MissouriMRDT/12V_Hardware/Hardware/2022_Rev2/2022_Rev2.kicad_pcb

## KiCad design Hardware/2022_Rev2/2022_Rev2.kicad_pcb (2022-08-24)

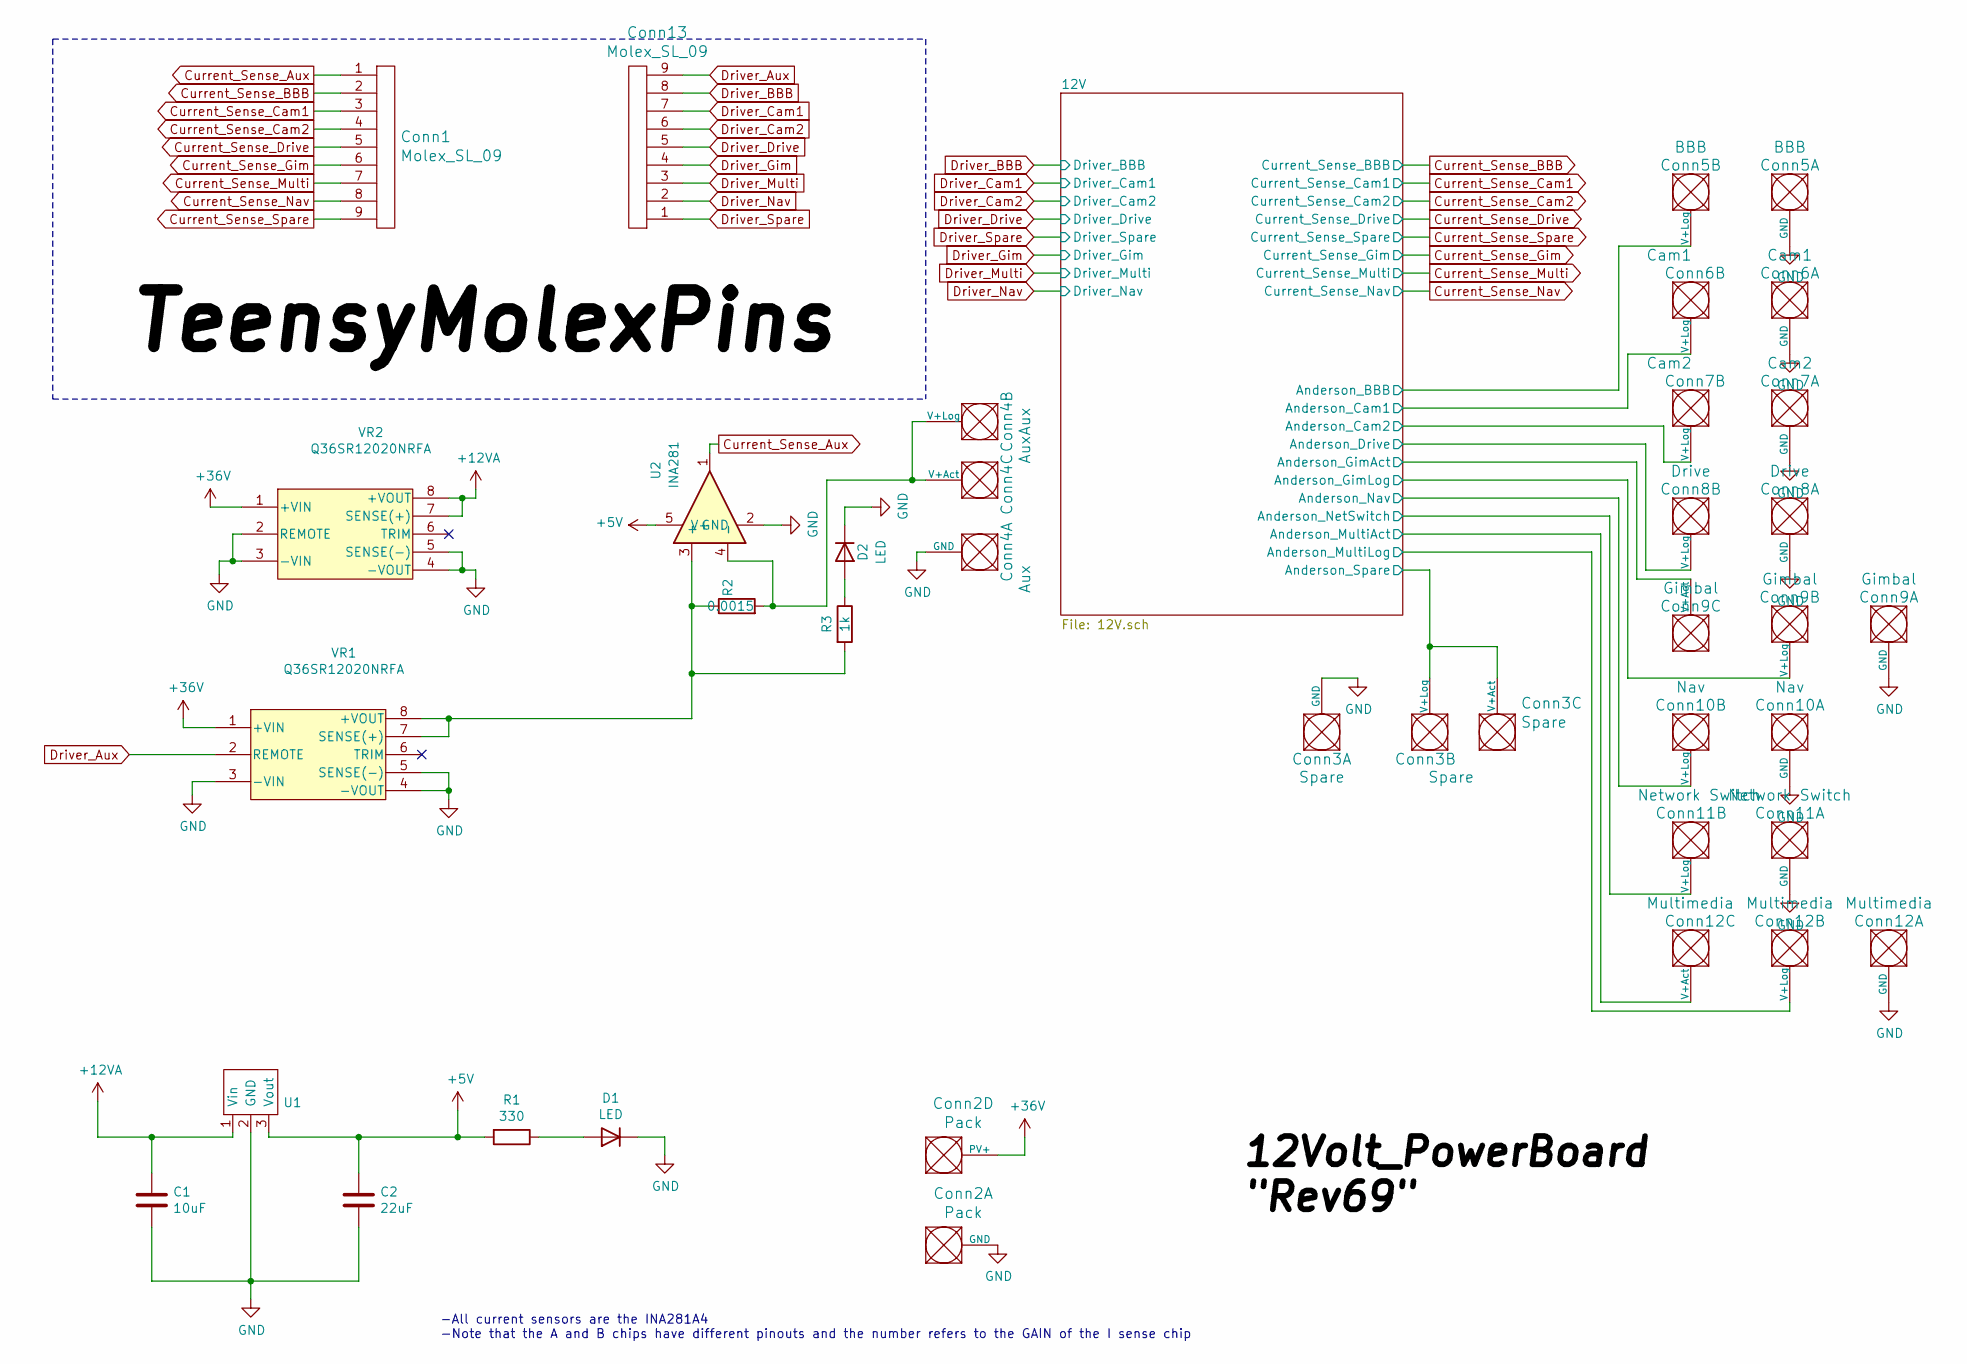
[picture p1: schematic 2022_Rev2.sch]

Parts:
C1: 10uF; C_0603_1608Metric_Pad1.05x0.95mm_HandSolder
C2: 22uF; C_0603_1608Metric_Pad1.05x0.95mm_HandSolder
Conn1, Conn13: Molex_SL_09; MOLEX_SL_09_Horizontal
Conn2: Pack; Square_Anderson_2_H_Stacked
Conn3: Spare; Square_Anderson_3_H_Side_By_Side
Conn4: Aux; Square_Anderson_3_H_Side_By_Side
Conn5: BBB; Square_Anderson_2_H_Stacked_PV
Conn6: Cam1; Square_Anderson_2_H_Stacked_PV
Conn7: Cam2; Square_Anderson_2_H_Stacked_PV
Conn8: Drive; Square_Anderson_2_H_Stacked_PV
Conn9: Gimbal; Square_Anderson_3_H_Side_By_Side
Conn10: Nav; Square_Anderson_2_H_Stacked_PV
Conn11: Network Switch; Square_Anderson_2_H_Stacked_PV
Conn12: Multimedia; Square_Anderson_3_H_Side_By_Side
D1, D2: LED; D_0603_1608Metric_Pad1.05x0.95mm_HandSolder
R1: 330; R_0603_1608Metric_Pad1.05x0.95mm_HandSolder
R2: 0.0015; R_2512_6332Metric_Pad1.52x3.35mm_HandSolder
R3: 1k; R_0603_1608Metric_Pad1.05x0.95mm_HandSolder
U1: TSR1-2433; TSR_1-2433
U2: INA281; SOT-23-5
VR1, VR2: Q36SR12020NRFA

Connections:
+5V: C2.1, R1.2, U1.3 (Vout), U2.5 (V+); also elsewhere on the board
+12VA: C1.1, Conn11.2 (V+Log), U1.1 (Vin), VR2.7 (SENSE(+)), VR2.8 (+VOUT); also elsewhere on the board
+36V: Conn2.4 (PV+), VR1.1 (+VIN), VR2.1 (+VIN)
/12V/Anderson_BBB: Conn5.2 (V+Log); also elsewhere on the board
/12V/Anderson_Cam1: Conn6.2 (V+Log); also elsewhere on the board
/12V/Anderson_Cam2: Conn7.2 (V+Log); also elsewhere on the board
/12V/Anderson_Drive: Conn8.2 (V+Log); also elsewhere on the board
/12V/Anderson_GimAct: Conn9.2 (V+Log), Conn9.3 (V+Act); also elsewhere on the board
/12V/Anderson_MultiAct: Conn12.2 (V+Log), Conn12.3 (V+Act); also elsewhere on the board
/12V/Anderson_Nav: Conn10.2 (V+Log); also elsewhere on the board
/12V/Anderson_Spare: Conn3.2 (V+Log), Conn3.3 (V+Act); also elsewhere on the board
Current_Sense_Aux: Conn1.1, U2.1
Current_Sense_BBB: Conn1.2; also elsewhere on the board
Current_Sense_Cam1: Conn1.3; also elsewhere on the board
Current_Sense_Cam2: Conn1.4; also elsewhere on the board
Current_Sense_Drive: Conn1.5; also elsewhere on the board
Current_Sense_Gim: Conn1.6; also elsewhere on the board
Current_Sense_Multi: Conn1.7; also elsewhere on the board
Current_Sense_Nav: Conn1.8; also elsewhere on the board
Current_Sense_Spare: Conn1.9; also elsewhere on the board
Driver_Aux: Conn13.9, VR1.2 (REMOTE)
Driver_BBB: Conn13.8; also elsewhere on the board
Driver_Cam1: Conn13.7; also elsewhere on the board
Driver_Cam2: Conn13.6; also elsewhere on the board
Driver_Drive: Conn13.5; also elsewhere on the board
Driver_Gim: Conn13.4; also elsewhere on the board
Driver_Multi: Conn13.3; also elsewhere on the board
Driver_Nav: Conn13.2; also elsewhere on the board
Driver_Spare: Conn13.1; also elsewhere on the board
GND: C1.2, C2.2, Conn2.1 (GND), Conn3.1 (GND), Conn4.1 (GND), Conn5.1 (GND), Conn6.1 (GND), Conn7.1 (GND), Conn8.1 (GND), Conn9.1 (GND), Conn10.1 (GND), Conn11.1 (GND), Conn12.1 (GND), D1.1 (K), D2.1 (K), U1.2 (GND), U2.2 (GND), VR1.3 (-VIN), VR1.4 (-VOUT), VR1.5 (SENSE(-)), VR2.2 (REMOTE), VR2.3 (-VIN), VR2.4 (-VOUT), VR2.5 (SENSE(-)); also elsewhere on the board
unnamed: Conn4.2 (V+Log), Conn4.3 (V+Act), R2.2, U2.4 (-)
unnamed: D1.2 (A), R1.1
unnamed: D2.2 (A), R3.1
unnamed: R2.1, R3.2, U2.3 (+), VR1.7 (SENSE(+)), VR1.8 (+VOUT)

Notes on the sheet:
-All current sensors are the INA281A4 -Note that the A and B chips have different pinouts and the number refers to the GAIN of the I sense chip

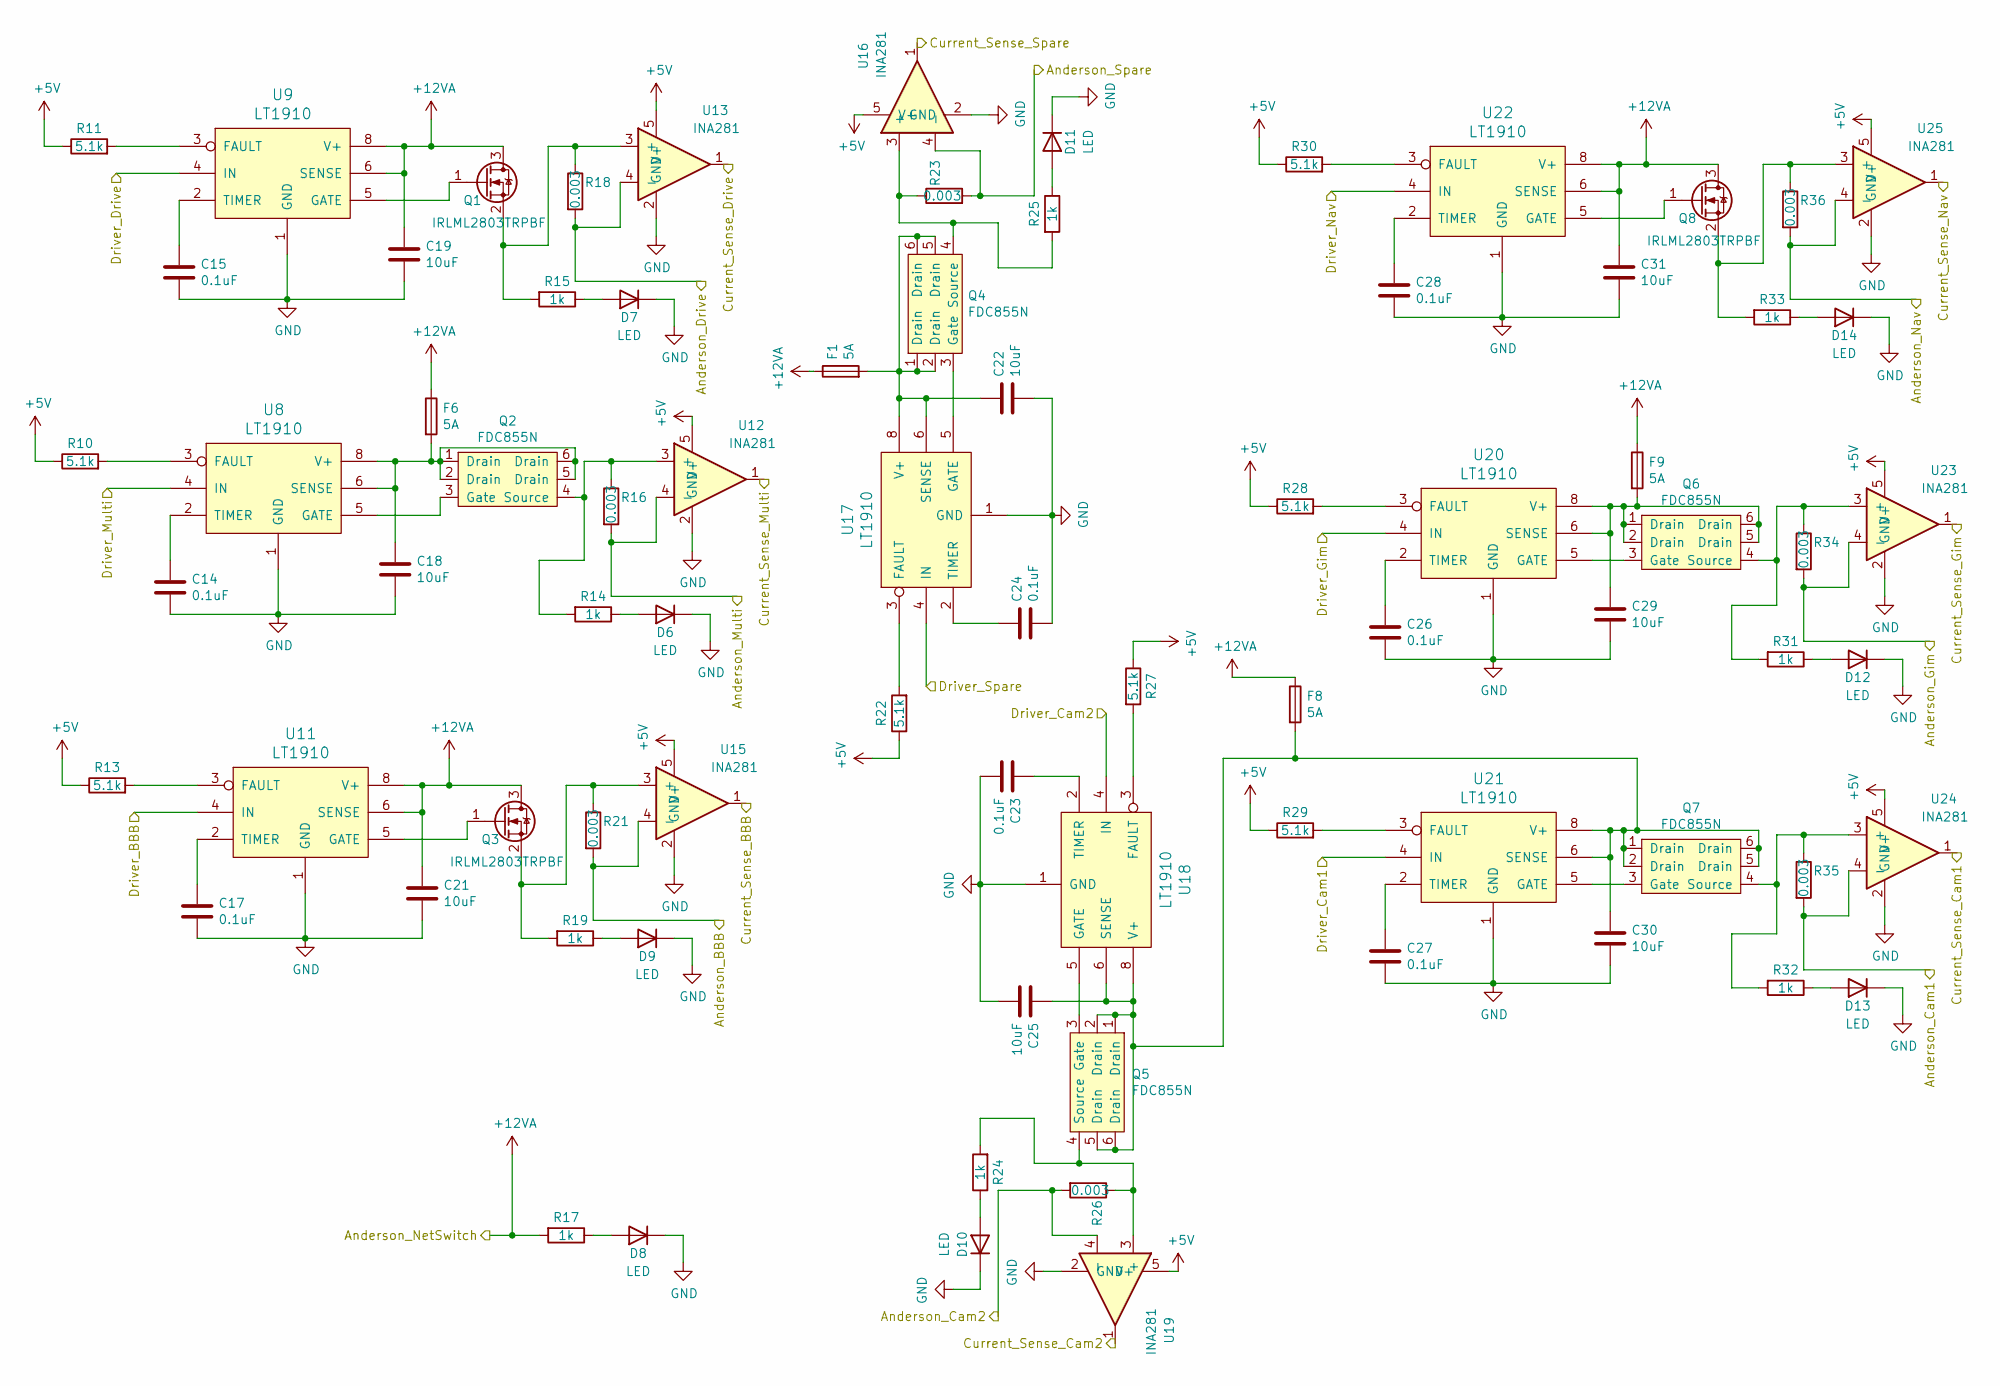
[picture p2: schematic Low Current Out.sch]

Parts:
C14, C15, C17, C23, C24, C26, C27, C28: 0.1uF; C_0603_1608Metric_Pad1.05x0.95mm_HandSolder
C18, C19, C21, C22, C25, C29, C30, C31: 10uF; C_0603_1608Metric_Pad1.05x0.95mm_HandSolder
D6, D7, D8, D9, D10, D11, D12, D13, D14: LED; D_0603_1608Metric_Pad1.05x0.95mm_HandSolder
F1, F6, F8, F9: 5A; ATC_Fuse_Block
Q1, Q3, Q8: IRLML2803TRPBF; SOT-23
Q2, Q4, Q5, Q6, Q7: FDC855N; SuperSOT-6
R10, R11, R13, R22, R27, R28, R29, R30: 5.1k; R_0603_1608Metric_Pad1.05x0.95mm_HandSolder
R14, R15, R17, R19, R24, R25, R31, R32, R33: 1k; R_0603_1608Metric_Pad1.05x0.95mm_HandSolder
R16, R18, R21, R23, R26, R34, R35, R36: 0.003; R_2010_5025Metric_Pad1.52x2.65mm_HandSolder
U8, U9, U11, U17, U18, U20, U21, U22: LT1910; SOIC-8_3.9x4.9mm_P1.27mm
U12, U13, U15, U16, U19, U23, U24, U25: INA281; SOT-23-5

Connections:
+5V: R10.1, R11.1, R13.1, R22.1, R27.1, R28.1, R29.1, R30.1, U12.5 (V+), U13.5 (V+), U15.5 (V+), U16.5 (V+), U19.5 (V+), U23.5 (V+), U24.5 (V+), U25.5 (V+); also elsewhere on the board
+12VA: C19.1, C21.1, C31.1, F1.1, F6.1, F8.1, F9.1, Q1.3 (D), Q3.3 (D), Q8.3 (D), R17.2, U9.6 (SENSE), U9.8 (V+), U11.6 (SENSE), U11.8 (V+), U22.6 (SENSE), U22.8 (V+); also elsewhere on the board
/12V/Anderson_BBB: R21.2, U15.4 (-); also elsewhere on the board
/12V/Anderson_Cam1: R35.2, U24.4 (-); also elsewhere on the board
/12V/Anderson_Cam2: R26.2, U19.4 (-); also elsewhere on the board
/12V/Anderson_Drive: R18.2, U13.4 (-); also elsewhere on the board
/12V/Anderson_GimAct: R34.2, U23.4 (-); also elsewhere on the board
/12V/Anderson_MultiAct: R16.2, U12.4 (-); also elsewhere on the board
/12V/Anderson_Nav: R36.2, U25.4 (-); also elsewhere on the board
/12V/Anderson_Spare: R23.2, U16.4 (-); also elsewhere on the board
Current_Sense_BBB: U15.1; also elsewhere on the board
Current_Sense_Cam1: U24.1; also elsewhere on the board
Current_Sense_Cam2: U19.1; also elsewhere on the board
Current_Sense_Drive: U13.1; also elsewhere on the board
Current_Sense_Gim: U23.1; also elsewhere on the board
Current_Sense_Multi: U12.1; also elsewhere on the board
Current_Sense_Nav: U25.1; also elsewhere on the board
Current_Sense_Spare: U16.1; also elsewhere on the board
Driver_BBB: U11.4 (IN); also elsewhere on the board
Driver_Cam1: U21.4 (IN); also elsewhere on the board
Driver_Cam2: U18.4 (IN); also elsewhere on the board
Driver_Drive: U9.4 (IN); also elsewhere on the board
Driver_Gim: U20.4 (IN); also elsewhere on the board
Driver_Multi: U8.4 (IN); also elsewhere on the board
Driver_Nav: U22.4 (IN); also elsewhere on the board
Driver_Spare: U17.4 (IN); also elsewhere on the board
GND: C14.2, C15.2, C17.2, C18.2, C19.2, C21.2, C22.2, C23.2, C24.2, C25.2, C26.2, C27.2, C28.2, C29.2, C30.2, C31.2, D6.1 (K), D7.1 (K), D8.1 (K), D9.1 (K), D10.1 (K), D11.1 (K), D12.1 (K), D13.1 (K), D14.1 (K), U8.1 (GND), U9.1 (GND), U11.1 (GND), U12.2 (GND), U13.2 (GND), U15.2 (GND), U16.2 (GND), U17.1 (GND), U18.1 (GND), U19.2 (GND), U20.1 (GND), U21.1 (GND), U22.1 (GND), U23.2 (GND), U24.2 (GND), U25.2 (GND); also elsewhere on the board
unnamed: C14.1, U8.2 (TIMER)
unnamed: C15.1, U9.2 (TIMER)
unnamed: C17.1, U11.2 (TIMER)
unnamed: C18.1, F6.2, Q2.1 (Drain), Q2.2 (Drain), Q2.5 (Drain), Q2.6 (Drain), U8.6 (SENSE), U8.8 (V+)
unnamed: C22.1, F1.2, Q4.1 (Drain), Q4.2 (Drain), Q4.5 (Drain), Q4.6 (Drain), U17.6 (SENSE), U17.8 (V+)
unnamed: C23.1, U18.2 (TIMER)
unnamed: C24.1, U17.2 (TIMER)
unnamed: C25.1, C30.1, F8.2, Q5.1 (Drain), Q5.2 (Drain), Q5.5 (Drain), Q5.6 (Drain), Q7.1 (Drain), Q7.2 (Drain), Q7.5 (Drain), Q7.6 (Drain), U18.6 (SENSE), U18.8 (V+), U21.6 (SENSE), U21.8 (V+)
unnamed: C26.1, U20.2 (TIMER)
unnamed: C27.1, U21.2 (TIMER)
unnamed: C28.1, U22.2 (TIMER)
unnamed: C29.1, F9.2, Q6.1 (Drain), Q6.2 (Drain), Q6.5 (Drain), Q6.6 (Drain), U20.6 (SENSE), U20.8 (V+)
unnamed: D6.2 (A), R14.1
unnamed: D7.2 (A), R15.1
unnamed: D8.2 (A), R17.1
unnamed: D9.2 (A), R19.1
unnamed: D10.2 (A), R24.1
unnamed: D11.2 (A), R25.1
unnamed: D12.2 (A), R31.1
unnamed: D13.2 (A), R32.1
unnamed: D14.2 (A), R33.1
unnamed: Q1.1 (G), U9.5 (GATE)
unnamed: Q1.2 (S), R15.2, R18.1, U13.3 (+)
unnamed: Q2.3 (Gate), U8.5 (GATE)
unnamed: Q2.4 (Source), R14.2, R16.1, U12.3 (+)
unnamed: Q3.1 (G), U11.5 (GATE)
unnamed: Q3.2 (S), R19.2, R21.1, U15.3 (+)
unnamed: Q4.3 (Gate), U17.5 (GATE)
unnamed: Q4.4 (Source), R23.1, R25.2, U16.3 (+)
unnamed: Q5.3 (Gate), U18.5 (GATE)
unnamed: Q5.4 (Source), R24.2, R26.1, U19.3 (+)
unnamed: Q6.3 (Gate), U20.5 (GATE)
unnamed: Q6.4 (Source), R31.2, R34.1, U23.3 (+)
unnamed: Q7.3 (Gate), U21.5 (GATE)
unnamed: Q7.4 (Source), R32.2, R35.1, U24.3 (+)
unnamed: Q8.1 (G), U22.5 (GATE)
unnamed: Q8.2 (S), R33.2, R36.1, U25.3 (+)
unnamed: R10.2, U8.3 (FAULT)
unnamed: R11.2, U9.3 (FAULT)
unnamed: R13.2, U11.3 (FAULT)
unnamed: R22.2, U17.3 (FAULT)
unnamed: R27.2, U18.3 (FAULT)
unnamed: R28.2, U20.3 (FAULT)
unnamed: R29.2, U21.3 (FAULT)
unnamed: R30.2, U22.3 (FAULT)

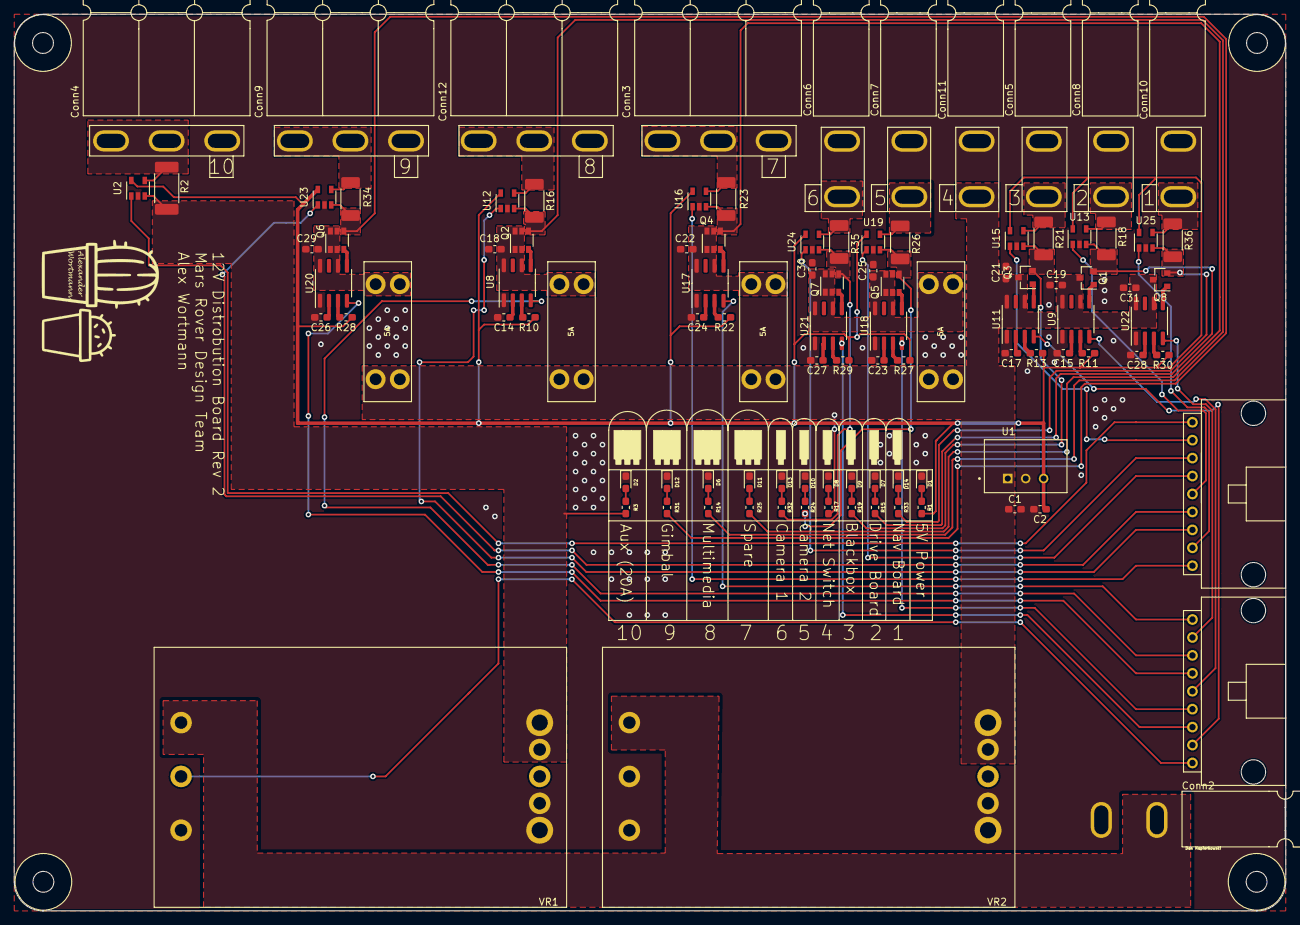
[picture p3: board 2022_Rev2.kicad_pcb from above]

Board: 2 copper layers, 180.1 x 127.0 mm, 102 parts (0 on the bottom side), 79 nets.
