MissouriMRDT/12V_Hardware/(commit log)

2020-09-11 Merged 2020 with master
    [12V_PowerBoard_BOM_Rev1.csv, 12V_Powerboard_Hardware.kicad_pcb, 12V_Powerboard_Hardware.sch, 12V_Powerboard_Hardware.step]
2022-02-20 Deleted old files and started on new 12V board
    [12V.sch, 12V_PowerBoard_BOM_Rev1.csv, 12V_Powerboard_Hardware.kicad_pcb, 12V_Powerboard_Hardware.sch, 12V_Powerboard_Hardware.step, 2022_Rev2.kicad_pcb, 2022_Rev2.sch, BuckAndersons.sch]
2022-02-23 Added Heirarchical Labels inside the 12V sheet
    [12V.sch, 2022_Rev2.sch, BuckAndersons.sch]
2022-02-26 Organized some stuff and added Teensy connections
    [12V.sch, 2022_Rev2.sch, BuckAndersons.sch, Low Current Out.sch, TEENSY.sch]
2022-02-26 closed file
    [12V.sch]
2022-02-26 Named the 12Volt Board
    [2022_Rev2.sch]
2022-03-09 Tiva implementation
    [12V.sch, 2022_Rev2.sch, BuckAndersons.sch, Low Current Out.sch, TEENSY.sch]
2022-03-09 change switch circuit naming + added more switch circuits.
    [12V.sch, High Current Outputs.sch, Low Current Out.sch]
2022-03-10 back to the teensy :alien:
    [12V.sch, 2022_Rev2.sch, BuckAndersons.sch, High Current Outputs.sch, Low Current Out.sch, TEENSY.sch]
2022-03-10 12v switch circuits added
    [12V.sch, 2022_Rev2.sch, BuckAndersons.sch, Low Current Out.sch]
2022-03-10 teensy pins are done (I think)
    [12V.sch, 2022_Rev2.sch, BuckAndersons.sch, Low Current Out.sch, TEENSY.sch]
2022-03-10 andersons done
    [2022_Rev2.sch, BuckAndersons.sch, TEENSY.sch]
2022-03-10 molex pins
    [12V.sch, 2022_Rev2.sch, BuckAndersons.sch, Low Current Out.sch]
2022-03-10 removed scilog/sciact
    [12V.sch, 2022_Rev2.sch, Low Current Out.sch]
2022-03-10 molex pins pt.2
    [2022_Rev2.sch, BuckAndersons.sch]
2022-03-10 assigning footprints pt.1
    [12V.sch, 2022_Rev2.sch, BuckAndersons.sch, Low Current Out.sch]
2022-03-10 Finished footprint signatures and started schematic
    [12V.sch, 2022_Rev2.kicad_pcb, 2022_Rev2.sch, BuckAndersons.sch, Low Current Out.sch]
2022-03-11 fixed footprints
    [2022_Rev2.kicad_pcb, 2022_Rev2.sch]
2022-03-12 Lots of Changes
    [12V.sch, 2022_Rev2.sch, BuckAndersons.sch, Low Current Out.sch]
2022-03-12 Fixed schematic and fixed annotations
    [12V.sch, 2022_Rev2.sch, BuckAndersons.sch, Low Current Out.sch]
2022-03-12 Assigned footprints and finished changes on schem
    [12V.sch, BuckAndersons.sch, Low Current Out.sch]
2022-03-16 Fixed many issues
    [12V.sch, 2022_Rev2.sch, BuckAndersons.sch, Low Current Out.sch]
2022-03-17 ahhhhhh ladybug is angy
    [12V.sch, 2022_Rev2.sch, Low Current Out.sch]
2022-03-18 Gerbs are done
    please review before you order this max
    [2022_Rev2-B_Cu.gbr, 2022_Rev2-B_Mask.gbr, 2022_Rev2-B_Paste.gbr, 2022_Rev2-B_SilkS.gbr, 2022_Rev2-Edge_Cuts.gbr, 2022_Rev2-F_Cu.gbr, 2022_Rev2-F_Mask.gbr, 2022_Rev2-F_Paste.gbr]
2022-03-18 made a comment about the current sensor
    [2022_Rev2.sch]
2022-03-18 changed board review complaints
    generated gerbs
    [2022_Rev2-B_Cu.gbr, 2022_Rev2-B_Mask.gbr, 2022_Rev2-B_Paste.gbr, 2022_Rev2-B_SilkS.gbr, 2022_Rev2-Edge_Cuts.gbr, 2022_Rev2-F_Cu.gbr, 2022_Rev2-F_Mask.gbr, 2022_Rev2-F_Paste.gbr]
2022-04-27 Created BOM
    [2022_Rev2.csv]
2022-05-02 renamed bom
    [2022_12V_Rev2.csv]
